salkhon/Rotating-LED-Display-with-Wireless-Control/README.md

# Rotating LED Display with Wireless Control
This microcontroller project was built as a part of my university's CSE316: Microprocessors, Microcontrollers, and Embedded Systems Sessional course. 

We built a rotating device that blinks with precise intervals, to display a digital clock, an analog clock, and any text received via Bluetooth.

# Report
You can read more about this project [here](https://github.com/salkhon/Rotating-LED-Display-with-Wireless-Control/blob/master/CSE316_Report.pdf).

# Video Demo
A video demo of the project can be watched [here](https://youtu.be/3YQeCUu519Q).
